mplewis/bean-sous-vide/Sous Vide/Sous Vide/Resources/Images/cool@2x~iphone.png

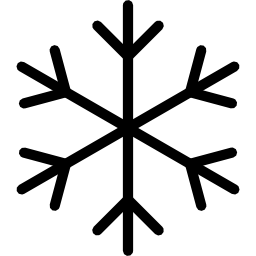
Sous Vide/Sous Vide/Resources/Images/cool@2x~iphone.png
