mplewis/bean-sous-vide/Sous Vide/Sous Vide/Resources/Images/help_lg@2x~iphone.png

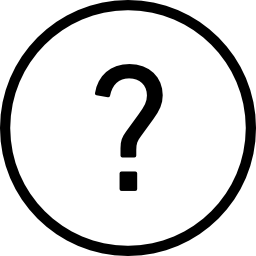
Sous Vide/Sous Vide/Resources/Images/help_lg@2x~iphone.png
