mplewis/bean-sous-vide/(commit log)

2014-06-19 Add nonfunctional Rescan button; connect to Bean and set status text accordingly
2014-06-20 Put switches in proper place
2014-06-20 Basic one-wire temperature sensor sketch
2014-06-20 DRY out ViewController; make display/timers more robust; implement enableControls inside status received
2014-06-20 Sketch now returns proper temperatures
2014-06-20 Remove dead Arduino code
2014-06-20 Return heating data; heat/cool on heater pin based on thermometer; poll thermometer at worst every 10 seconds
2014-06-21 Add HEATING state
2014-06-21 Change from buttons to slider; fix UI bugginess
2014-06-23 Update Arduino trigger points
2014-06-23 Comment Arduino code
